michalmonday/xohw23-121/images/block_design.pdf

### DDR FIXED_IO

### axi_gpio_0

### AXI GPIO

S_AXI | GPIO
| gpio_io_o[31:0] GPIO2

gpio2_io_i[31:0]

s_axi_aclk

s_axi_aresetn

### axi_gpio_1

### AXI GPIO

S_AXI | GPIO

gpio_io_o[31:0] s_axi_aclk

s_axi_aresetn

### axi_smc

### AXI SmartConnect

S00_AXI

# M00_AXI M01_AXI M02_AXI M03_AXI M04_AXI M05_AXI M06_AXI M07_AXI

aclk aresetn

### bram_loader

S_AXI | Dout[0:0]
s_axi_aclk s_axi_aresetn | data[255:0] addr[31:0]

### bram_logic

Din[352:0] Op1[0:0] | Dout[0:0]
clka | dina[255:0]
rst_n | delayed_sig
| addra[31:0] douta[255:0]

web[0:0] addrb[31:0] dinb[255:0]

### console_io

S_AXI

clk Op2[0:0] | rd_en[0:0] wr_en wr_data[7:0] | counter[10:0] empty

rd_data[7:0]

counter1[10:0]

s_axi_aresetn

rst_n1

rst_n2 Op3[0:0] Op1[63:0]

### continuous_monitoring_system_blocks

M_AXIS

S_AXI_LITE

M00_AXI

S_AXI aresetn

aclk

axis_wr_data_count[31:0]

performance_events[38:0] en

tlast_interval[31:0] pc[63:0]

instr[31:0]

auipc_counter_probe2[6:0] auipc_event_probe2

data_pkt_auipc_counter_probe1[6:0] data_pkt_branch_counter_probe1[6:0] data_pkt_instr_probe1[32:0] data_pkt_jal_counter_probe1[6:0] data_pkt_pc_probe1[63:0] performance_counters_rst_n_probe1

branch_counter_probe3[6:0] branch_event_probe3

jal_counter_probe3[6:0]

jal_event_probe3

### gpio_0

### Slice

Din[31:0] | Dout[0:0]

### gpio_1_rst_console_input

### Slice

Din[31:0] | Dout[0:0]

### gpio_2_rst_console_output

### Slice

Din[31:0] | Dout[0:0]

### mkSoC_Top_1

### mkSoC_Top_v1_0

CLK RST_N

EN_to_raw_mem_request_get

to_raw_mem_request_get[352:0] RDY_to_raw_mem_request_get

to_raw_mem_response_put[255:0] EN_to_raw_mem_response_put

RDY_to_raw_mem_response_put

EN_get_to_console_get

get_to_console_get[7:0] RDY_get_to_console_get

put_from_console_put[7:0] EN_put_from_console_put

RDY_put_from_console_put

status[7:0]

set_verbosity_verbosity[3:0]

set_verbosity_logdelay[63:0] EN_set_verbosity

RDY_set_verbosity

set_watch_tohost_watch_tohost

set_watch_tohost_tohost_addr[63:0] EN_set_watch_tohost

RDY_set_watch_tohost mv_tohost_value[63:0] RDY_mv_tohost_value

EN_ma_ddr4_ready

RDY_ma_ddr4_ready mv_status[7:0]

cms_ifc_pc[63:0]

cms_ifc_instr[31:0]

cms_ifc_pc_valid[8:0]

cms_ifc_stage1_ostatus[1:0]

cms_ifc_stage1_control[3:0]

cms_ifc_stage2_ostatus[1:0]

cms_ifc_performance_events[38:0]

cms_ifc_perf_jal

cms_ifc_perf_branch

cms_ifc_perf_auipc

### proc_sys_reset_0

### Processor System Reset

slowest_sync_clk ext_reset_in

aux_reset_in mb_debug_sys_rst dcm_locked

mb_reset bus_struct_reset[0:0] peripheral_reset[0:0]

interconnect_aresetn[0:0] peripheral_aresetn[0:0]

### processing_system7_0

### ZYNQ7 Processing System

DDR

FIXED_IO

USBIND_0 S_AXI_HP0_FIFO_CTRL | M_AXI_GP0 S_AXI_HP0 | TTC0_WAVE0_OUT

TTC0_WAVE1_OUT

TTC0_WAVE2_OUT

M_AXI_GP0_ACLK

S_AXI_HP0_ACLK

FCLK_CLK0 FCLK_RESET0_N

### system_ila_0

### System ILA

SLOT_0_AXIS
clk probe0[255:0] probe1[0:0] probe2[31:0] probe3[63:0] probe4[0:0] probe5[31:0] probe6[255:0] probe7[0:0] probe8[7:0] probe9[0:0] probe10[0:0] probe11[10:0] probe12[10:0] probe13[0:0] probe14[0:0] probe15[0:0] probe16[7:0] probe17[6:0] probe18[0:0]

resetn
probe19[6:0] probe20[6:0] probe21[32:0] probe22[6:0] probe23[63:0] probe24[0:0] probe25[6:0] probe26[0:0] probe27[6:0] probe28[0:0]

### xlconstant_0

### Constant

dout[0:0]

## GPIO bit index=0 Controls reset line (active low)

After importing EMIO GPIOs in pynq, it isn't possible to use DMA anymore (because it seems to use these)

## GPIO bit index=1 Controls EN_cpu_reset_server_request_put (tells CPU to reset itself)

GPIO bit index=3 Select FIFO (to avoid FIFO being filled during transfer to PS which results in pynq error)

## RDY_to_raw_mem_response_put looks always HIGH

EN_cpu_reset_server_response_get acknowledges that the notification about complete core reset was received
