michalmonday/xohw23-121/images/block_design_2.png

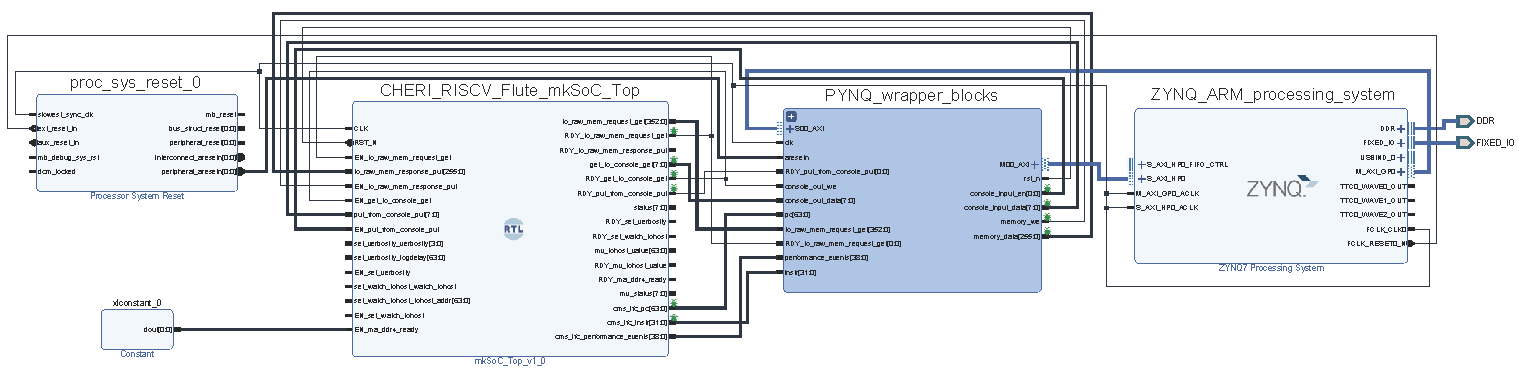
images/block_design_2.png
