michalmonday/xohw23-121/images/block_design_gpio_to_cms_ctrl_interface.png

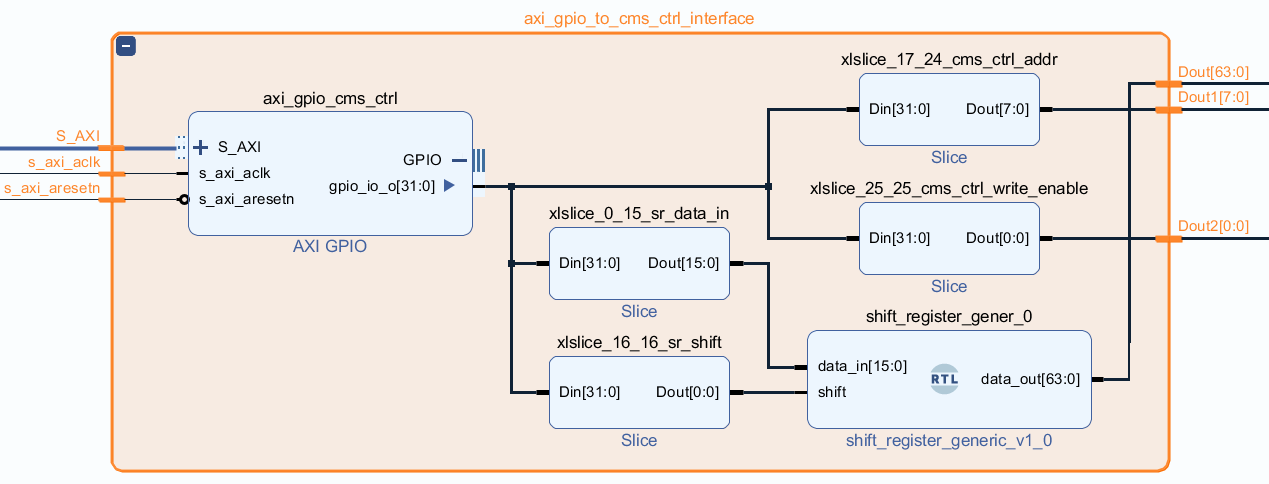
images/block_design_gpio_to_cms_ctrl_interface.png
