michalmonday/xohw23-121/images/block_design_sensors_blocks.png

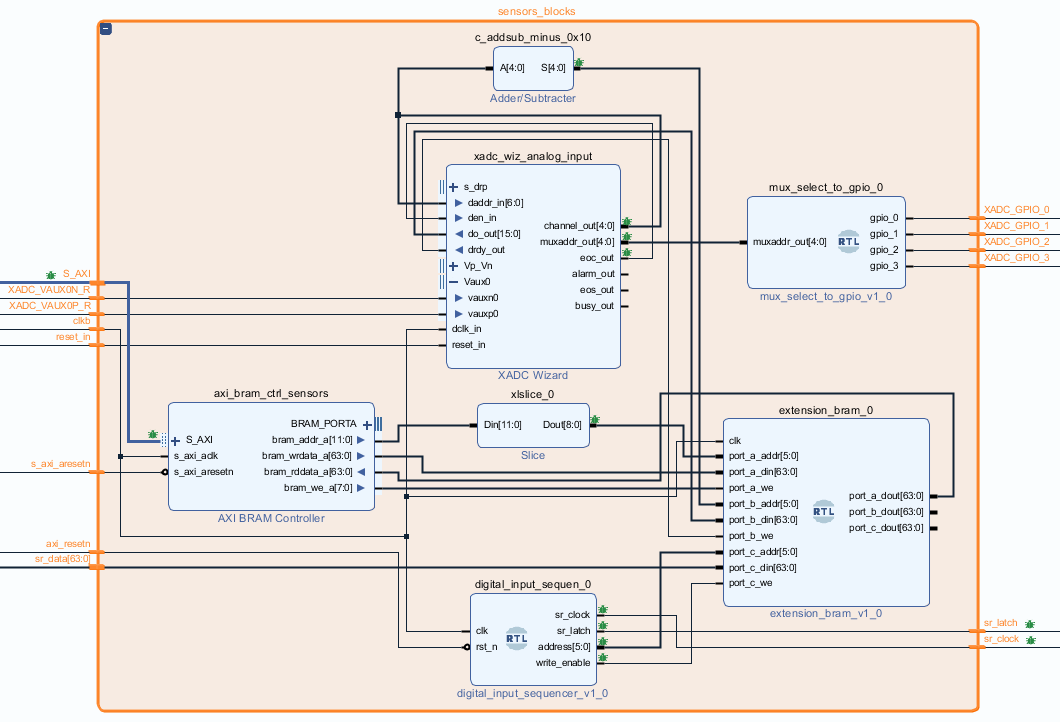
images/block_design_sensors_blocks.png
