michalmonday/xohw23-121/images/cms_configuration.png

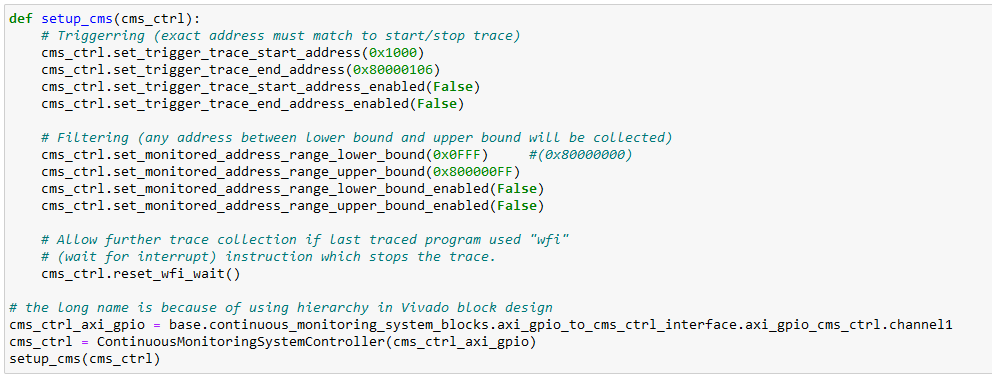
images/cms_configuration.png
