michalmonday/xohw23-121/images/cms_configuration_definitions.png

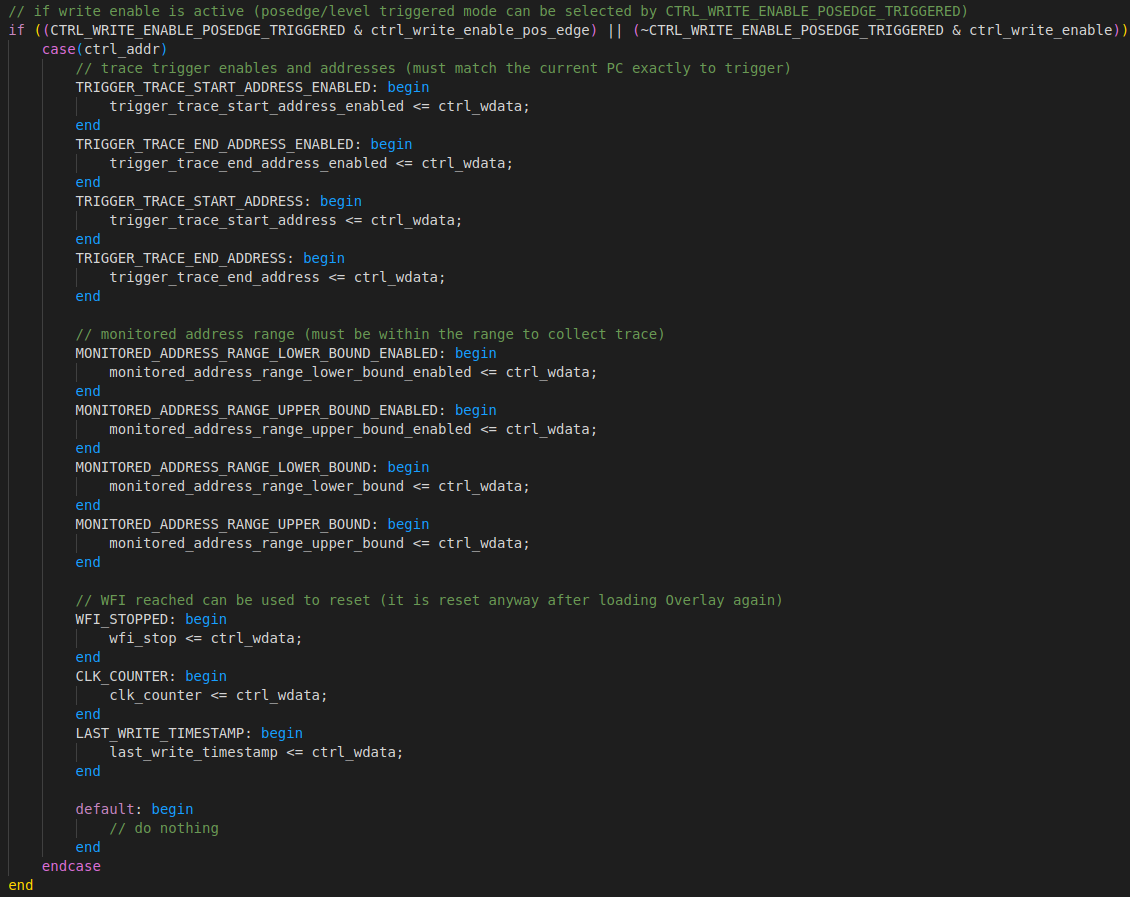
images/cms_configuration_definitions.png
