michalmonday/xohw23-121/images/cms_ifc.png

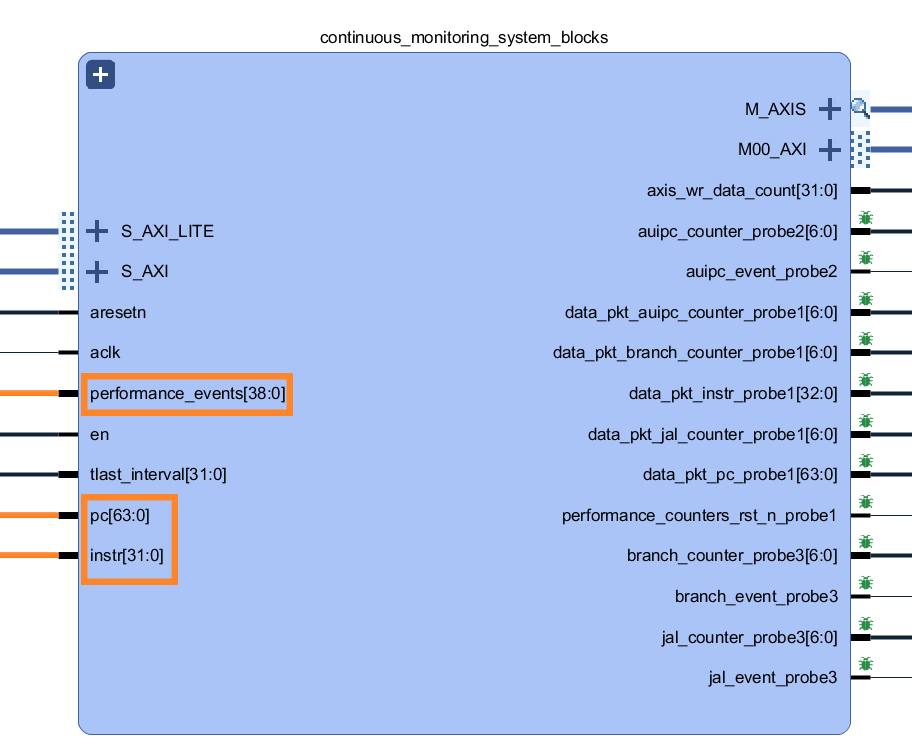
images/cms_ifc.png
