michalmonday/xohw23-121/images/datapath.png

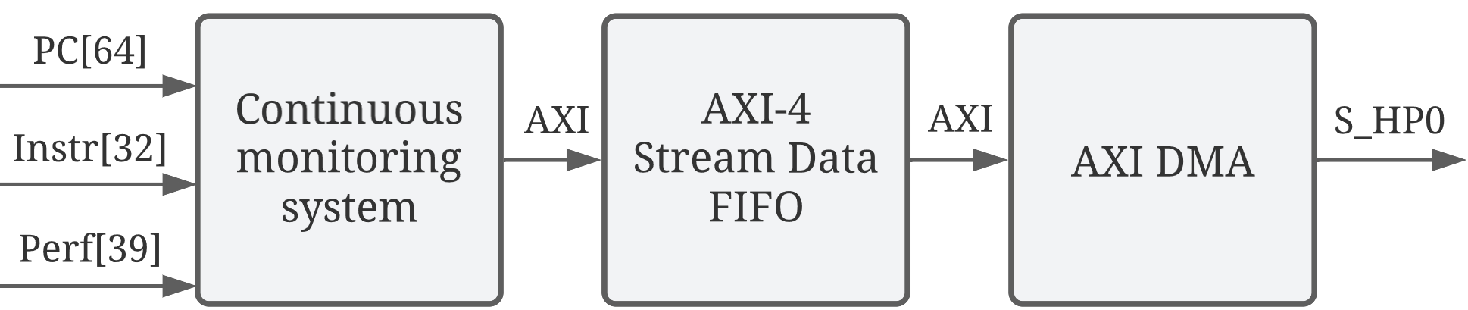
images/datapath.png
