michalmonday/xohw23-121/images/display.png

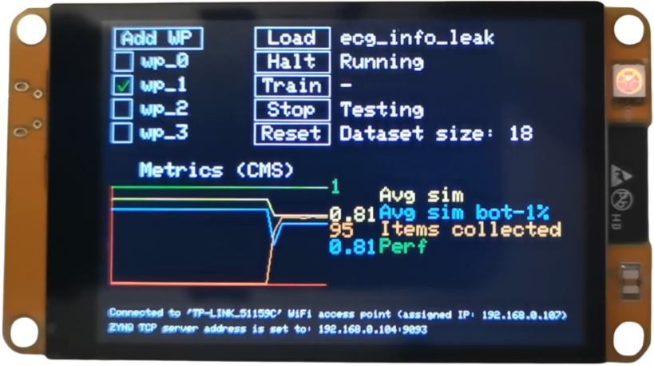
images/display.png
