michalmonday/xohw23-121/images/jupyter_notebook.png

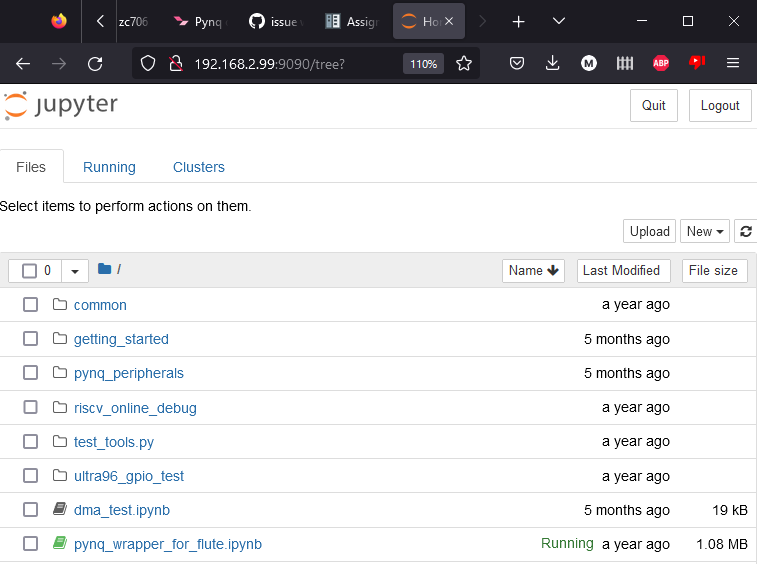
images/jupyter_notebook.png
