michalmonday/xohw23-121/images/other_peripherals_address_map.png

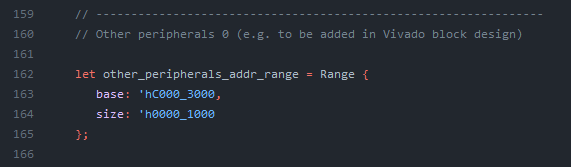
images/other_peripherals_address_map.png
