michalmonday/xohw23-121/images/overview.png

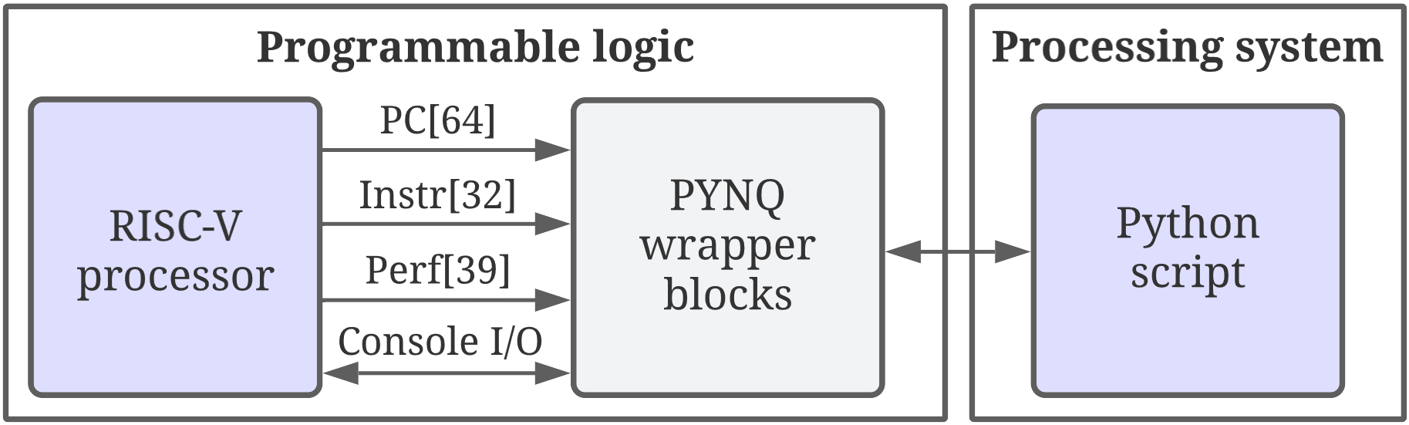
images/overview.png
