michalmonday/xohw23-121/images/overview_detailed.png

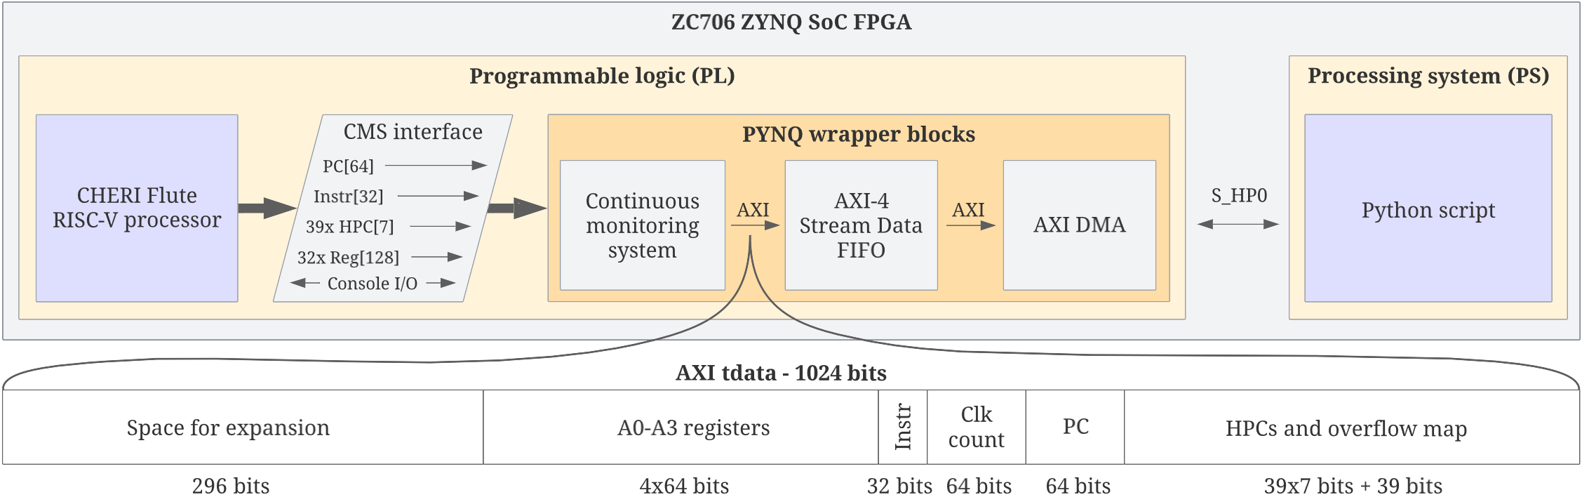
images/overview_detailed.png
