michalmonday/xohw23-121/images/overview_detailed_2.png

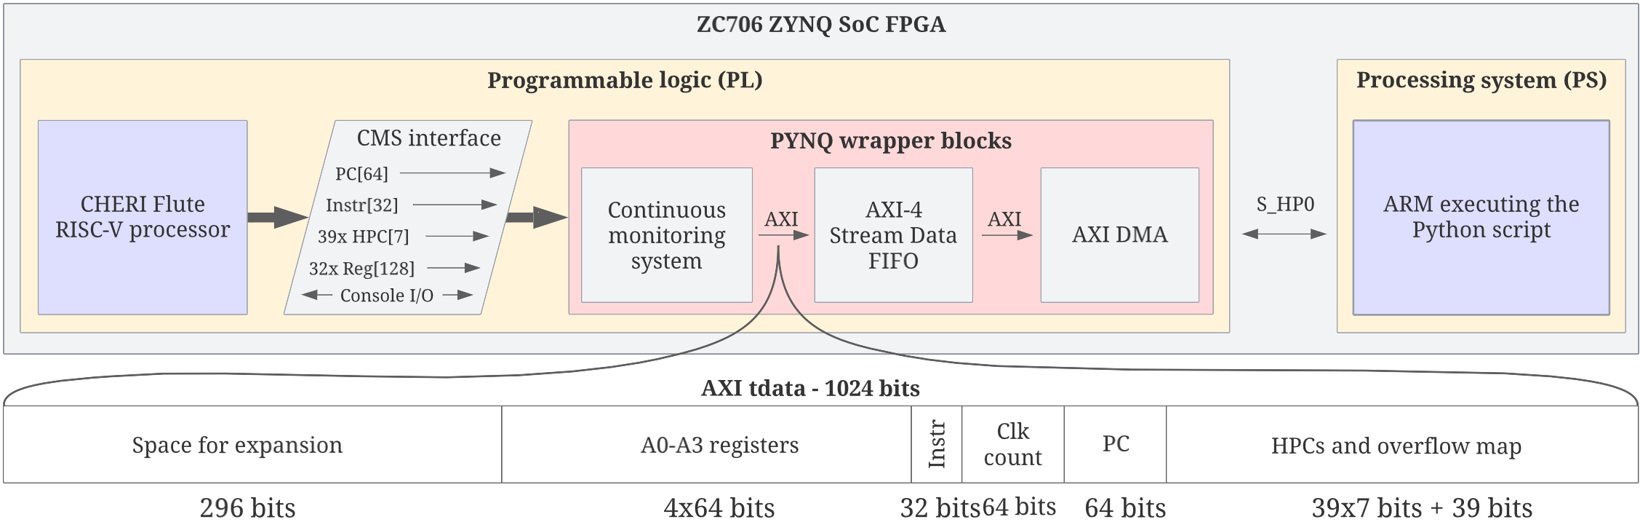
images/overview_detailed_2.png
