michalmonday/xohw23-121/images/pynq_overview.png

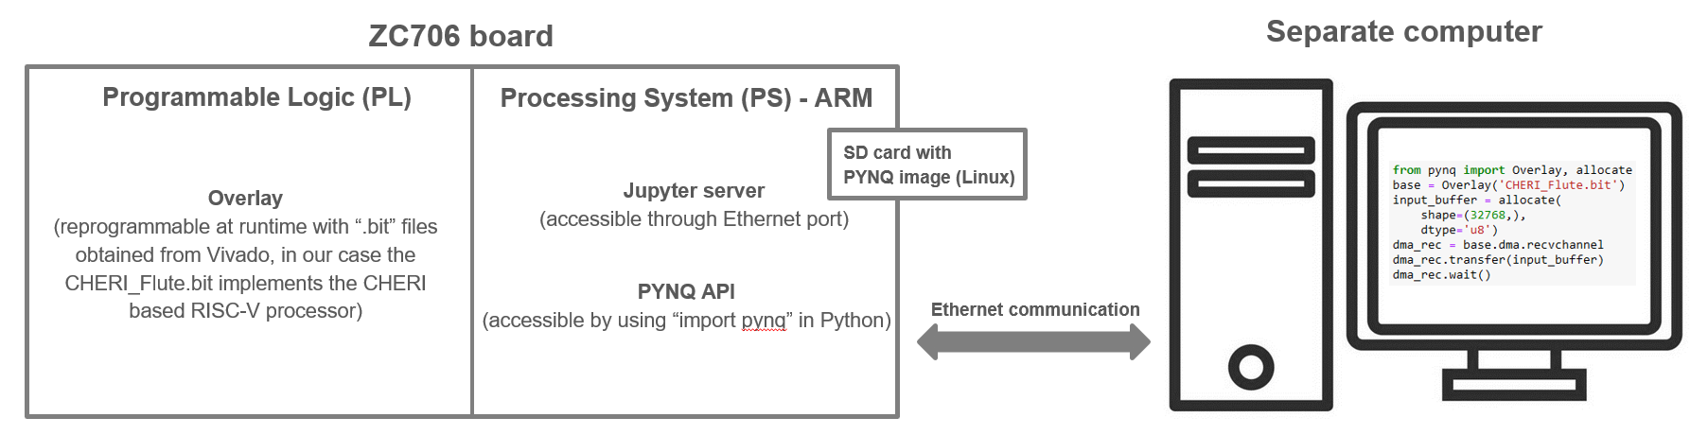
images/pynq_overview.png
