michalmonday/xohw23-121/images/soc_map_modification.png

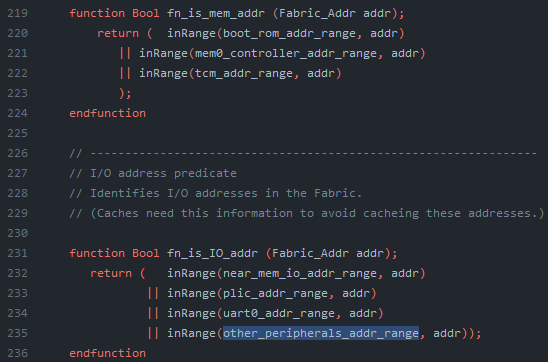
images/soc_map_modification.png
