michalmonday/xohw23-121/images/static_ip.png

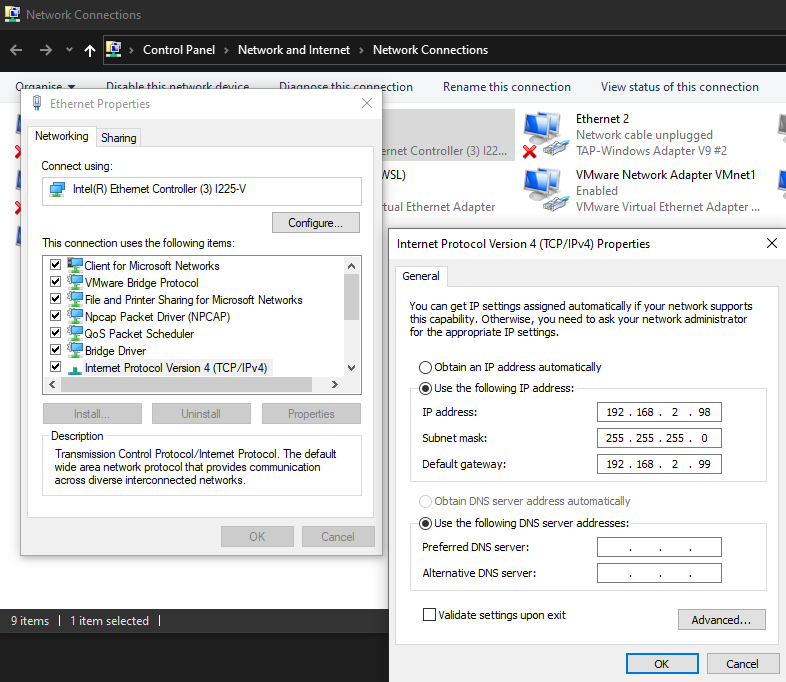
images/static_ip.png
