michalmonday/xohw23-121/images/tdata.png

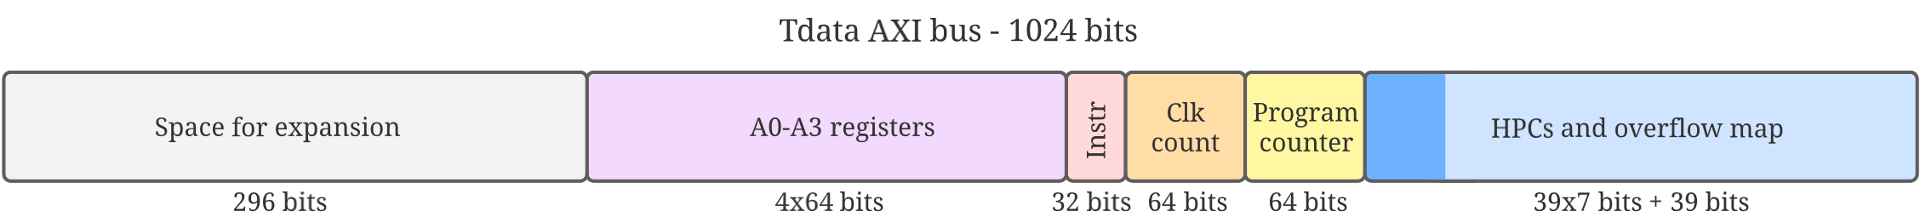
images/tdata.png
