michalmonday/xohw23-121/images/throughput.png

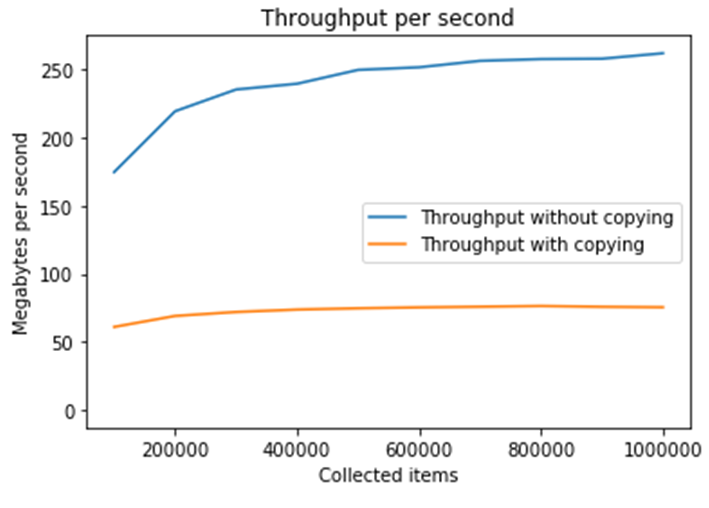
images/throughput.png
