michalmonday/xohw23-121/images/throughput_bigger_font.png

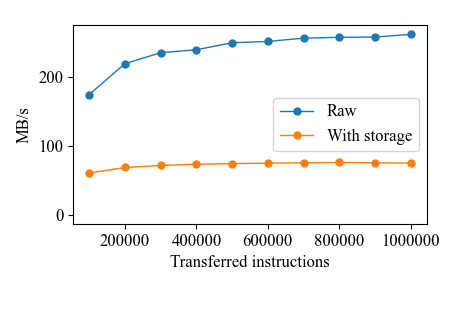
images/throughput_bigger_font.png
