michalmonday/xohw23-121/images/vulnerability.png

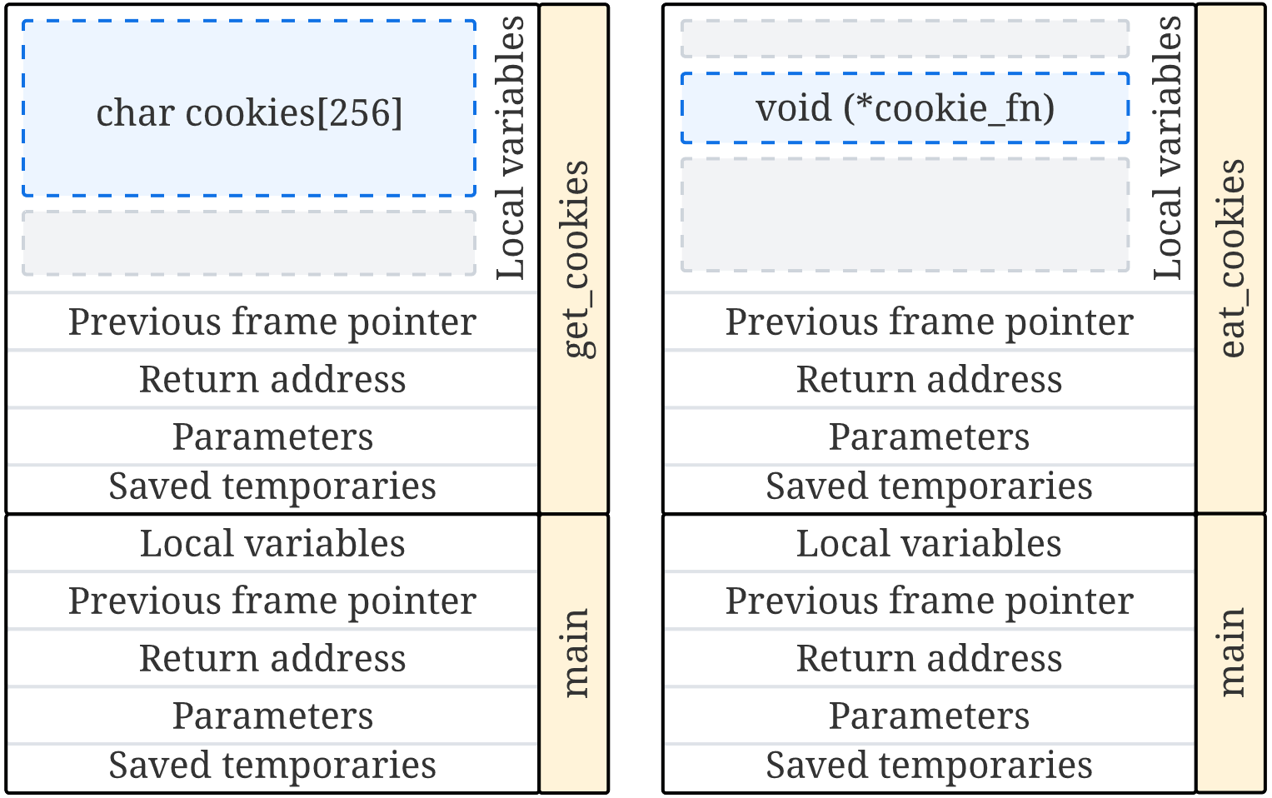
images/vulnerability.png
