michalmonday/xohw23-121/images/vulnerability_shorter.png

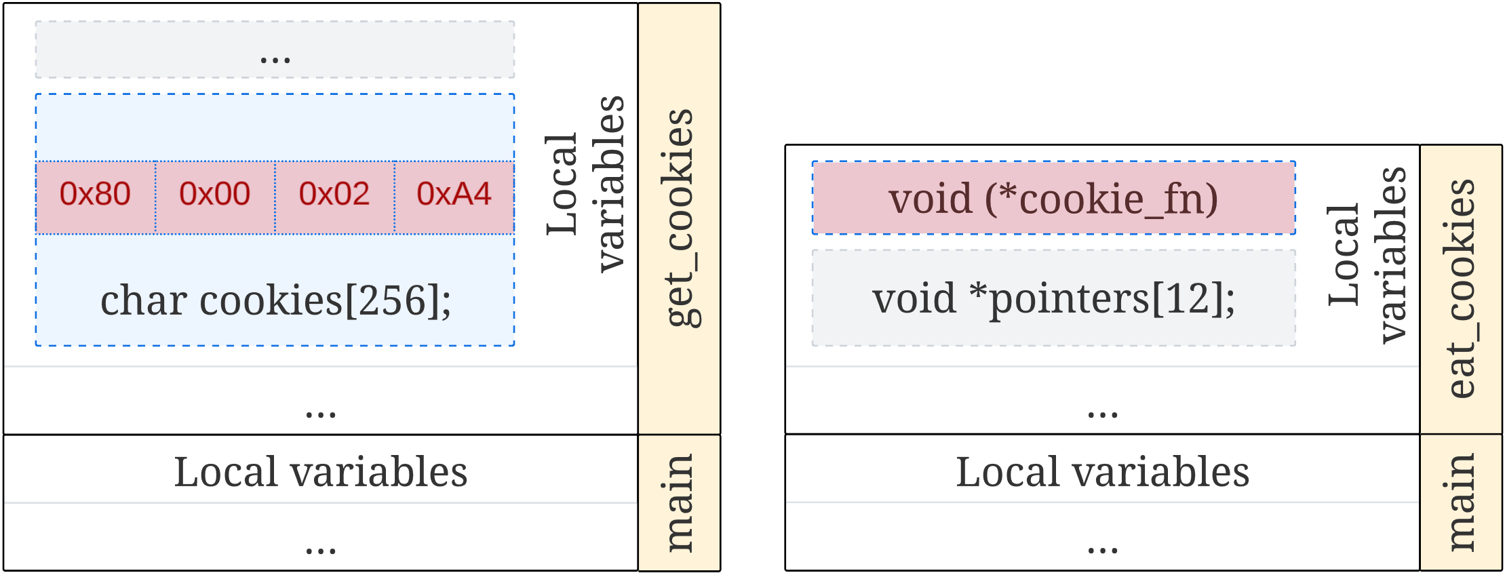
images/vulnerability_shorter.png
