michalmonday/xohw23-121/images/workaround_bram_controller_address.png

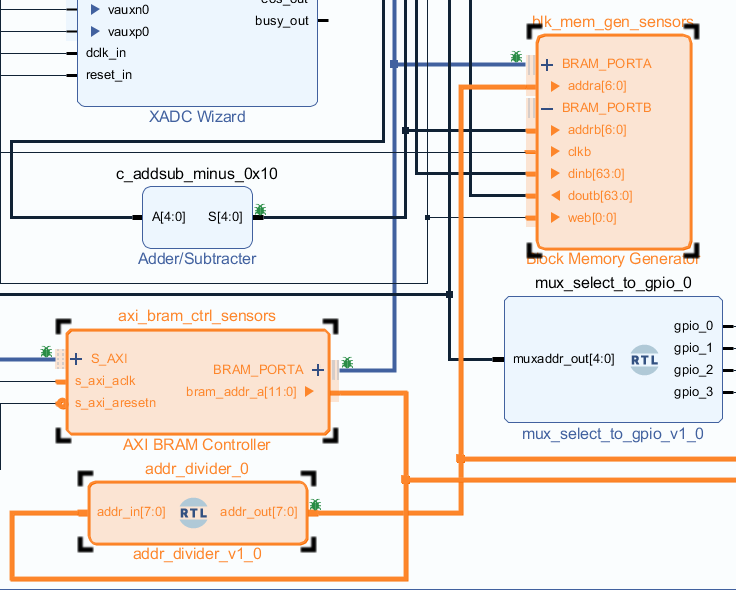
images/workaround_bram_controller_address.png
