michalmonday/xohw23-121/images/xadc_header_j63.png

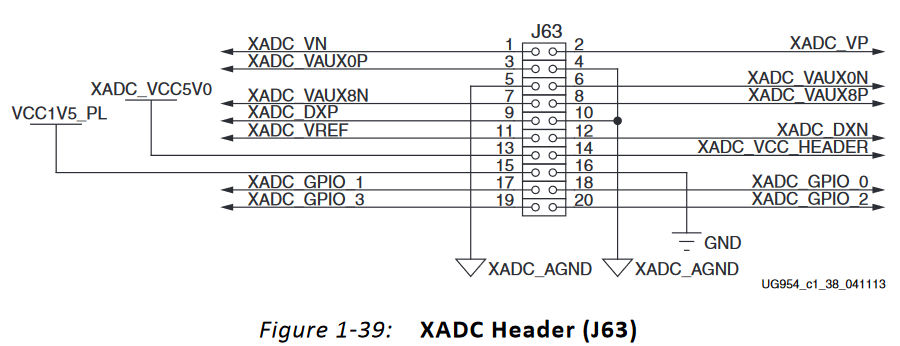
images/xadc_header_j63.png
