michalmonday/xohw23-121/images/zoomed_in_plot.png

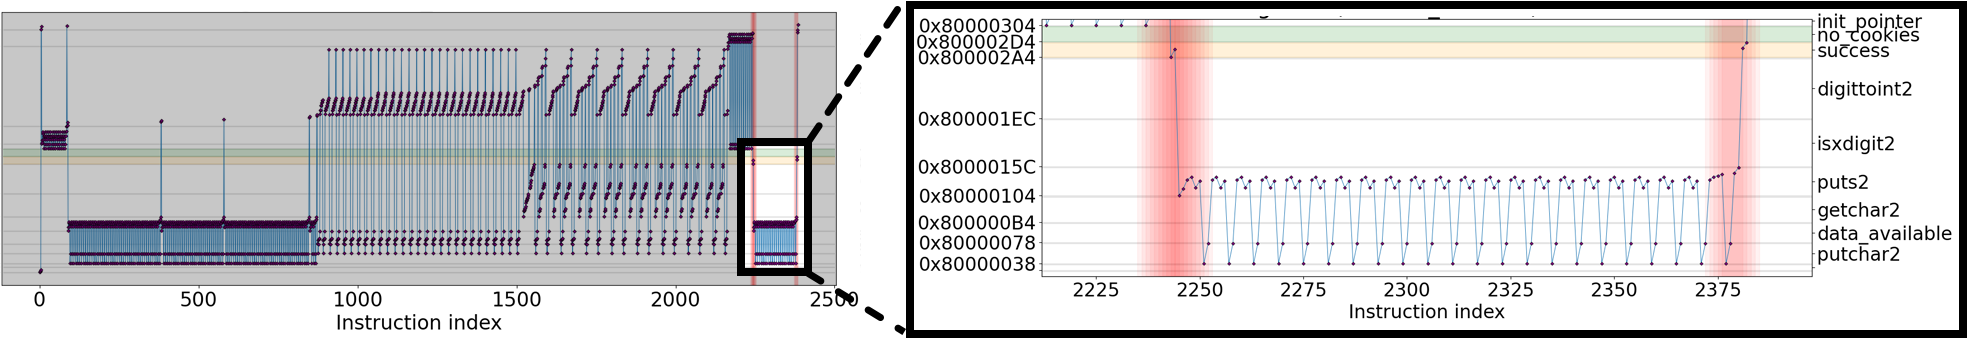
images/zoomed_in_plot.png
