michalmonday/xohw23-121/images/performance_events_variations.png

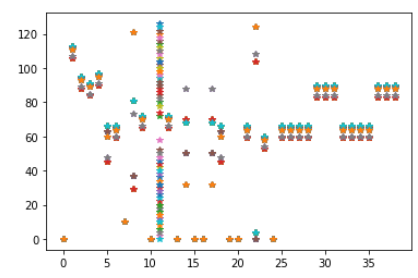
images/performance_events_variations.png
