michalmonday/xohw23-121/images/performance_penalty.png

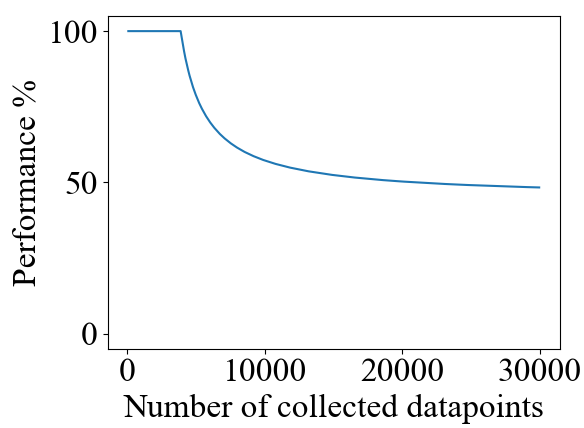
images/performance_penalty.png
