michalmonday/xohw23-121/images/performance_penalty_2.png

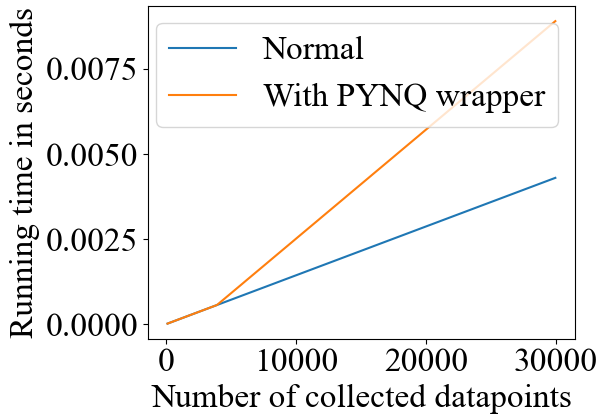
images/performance_penalty_2.png
