michalmonday/xohw23-121/images/results_bigger_font2.pdf

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

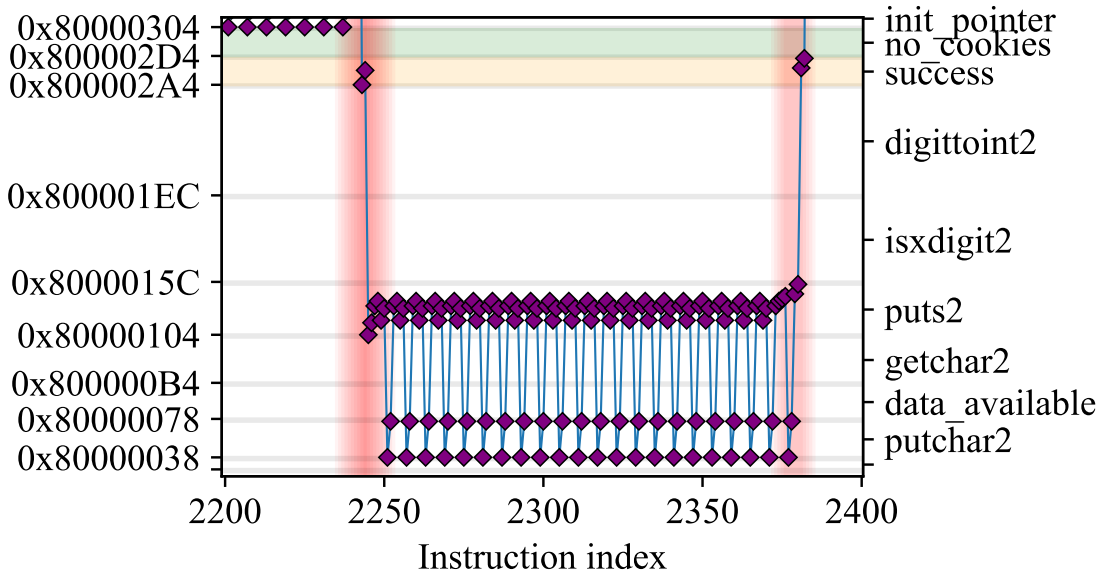
[picture p79: page 1]
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
