michalmonday/xohw23-121/display_board/src/touch_print/touch_print.cpp

#include "TAMC_GT911.h"
 // 63
#define TOUCH_SDA  19
#define TOUCH_SCL  20
#define TOUCH_INT -1
#define TOUCH_RST 38
#define TOUCH_WIDTH  800
#define TOUCH_HEIGHT 480

// #define TOUCH_GT911_SCL 20
// #define TOUCH_GT911_SDA 19
// #define TOUCH_GT911_INT -1
// #define TOUCH_GT911_RST 38

TAMC_GT911 *tp;

void setup() {
  Serial.begin(115200);
  Serial.println("TAMC_GT911 Example: Ready");
  tp = new TAMC_GT911(TOUCH_SDA, TOUCH_SCL, TOUCH_INT, TOUCH_RST, TOUCH_WIDTH, TOUCH_HEIGHT);
  tp->begin();
  // tp->setRotation(ROTATION_LEFT);
  // tp->setRotation(ROTATION_NORMAL);
  tp->setRotation(ROTATION_INVERTED);
}

void loop() {
  tp->read();
  if (tp->isTouched){
    for (int i=0; i<tp->touches; i++){
      Serial.print("Touch ");Serial.print(i+1);Serial.print(": ");;
      Serial.print("  x: ");Serial.print(tp->points[i].x);
      Serial.print("  y: ");Serial.print(tp->points[i].y);
      Serial.print("  size: ");Serial.println(tp->points[i].size);
      Serial.println(' ');
    }
  }
}
