michalmonday/xohw23-121/vivado_files/src_verilog/custom_hdl/console_io_dma.v

/*
This module is responsible for intermediate storage and interfacing between RISC-V console input/output and the Python script (using AXI DMA).
*/
`timescale 1ns/10ps

module console_io_dma #(
    DATA_DEPTH = 1000
) (
    input clk,
    input rst_n,

    // in DMA version these 2 signals must be replaced

    // this was providing read enable for output, write enable for input, and input data
    // input [31:0] AXI_GPIO_input, 

    // this was providing output data, and output empty status
    // output reg [31:0] AXI_GPIO_output = 0,

    // input output_read_en,
    input output_tready,
    output reg [7:0]output_data_reg,
    output reg output_tvalid_delayed,

    input [7:0]input_data,
    input input_write_en,
    output wire input_not_full,

    // input fifo signals
    input rst_n_input_fifo,
    input cpu_reset_completed,
    input RDY_put_from_console_put,
    output wire [7:0] put_from_console_put,
    output reg EN_put_from_console_put = 0,
    output wire [10:0] input_fifo_counter,

    // output fifo signals
    input rst_n_output_fifo,
    input [7:0] get_to_console_get,
    input RDY_get_to_console_get,
    output wire [10:0] output_fifo_counter,
    input wire receive_transfer_request,
    output reg output_tlast_reg
);
    wire input_fifo_wr_en; 
    wire input_fifo_empty;
    reg input_fifo_rd_en = 0;// wire  = (rst_n & cpu_reset_completed & RDY_put_from_console_put & ~input_fifo_empty);

    wire output_fifo_wr_en = RDY_get_to_console_get || receive_transfer_request;
    wire output_fifo_empty;
    wire [7:0] output_data;
    wire [7:0] output_fifo_wr_data = receive_transfer_request ? 'hFF : get_to_console_get;

    assign input_not_full = input_fifo_counter < DATA_DEPTH-1;
    assign last_output_char_available = output_fifo_counter == 1;

    // detects that RDY_put_from_console_put has gone from 1 to 0 and the char can't be sent
    // (char is outputted by fifo after 1 clock cycle of enabling read, and at that point the RDY_put_from_console_put may be already 0)
    reg RDY_put_from_console_put_was_off = 0;

    wire output_read_en = output_tready & (~output_fifo_empty || RDY_get_to_console_get);

    wire output_tlast;
    reg output_tvalid;

    // output fifo isn't expected to be read at such high speed (it's read by AXI GPIO)
    // so such mechanism is not needed (at least for now)

    // edge_detector input_fifo_wr_en_edge_detector(
    //     .clk(clk),
    //     .sig(AXI_GPIO_input[8]),
    //     .pos_edge(input_fifo_wr_en)
    // );

    sync_fifo #(
        .DATA_DEPTH(DATA_DEPTH),
        .DATA_WIDTH(8)
    ) input_fifo (
        .clk(clk),
        .rst_n(rst_n_input_fifo),
        .rd_en(input_fifo_rd_en),
        .wr_en(input_write_en & input_not_full),
        .wr_data(input_data),
        .rd_data(put_from_console_put),
        .full(),
        .empty(input_fifo_empty),
        .half(),
        .counter(input_fifo_counter)
    );

    // while keeping it empty
    // always @(posedge clk) begin
    //     AXI_GPIO_output <= {output_fifo_empty, output_data};
    // end
    always @(posedge clk) begin
        // if fifo is empty but both: read enable and write enable are HIGH,
        // then the char is outputted by fifo while keeping it empty
        output_tvalid_delayed <= output_tvalid;
        output_tvalid <= output_read_en;

        output_data_reg <= output_data;
        output_tlast_reg <= output_tlast; 
    end

    always @(posedge clk) begin
        if(!rst_n) begin
            EN_put_from_console_put <= 0;
        end
        else begin
            if (rst_n & cpu_reset_completed & RDY_put_from_console_put & ~input_fifo_empty & ~input_fifo_rd_en & ~EN_put_from_console_put) begin
                input_fifo_rd_en <= 1;
            end
            else begin
                input_fifo_rd_en <= 0;
            end
            EN_put_from_console_put <= input_fifo_rd_en;

            // if (~RDY_put_from_console_put) begin
            //     if (input_fifo_rd_en) begin
            //         RDY_put_from_console_put_was_off <= 1;
            //     end
            //     EN_put_from_console_put <= 0;
            // end
            // else if (RDY_put_from_console_put_was_off) begin
            //     // if the last char couldn't be sent and the RDY_put_from_console_put has gone from 0 to 1, then send the char
            //     RDY_put_from_console_put_was_off <= 0;
            //     EN_put_from_console_put <= 1;
            // end
            // else begin
            //     EN_put_from_console_put <= input_fifo_rd_en;
            // end
        end
    end


    // edge_detector output_fifo_rd_en_edge_detector(
    //     .clk(clk),
    //     .sig(AXI_GPIO_input[9]),
    //     .pos_edge(output_fifo_rd_en)
    // );
    sync_fifo  #(
        .DATA_DEPTH(DATA_DEPTH),
        .DATA_WIDTH(8 + 1) // +1 for tlast
    ) output_fifo (
        .clk(clk),
        .rst_n(rst_n_output_fifo),
        .rd_en(output_read_en),
        .wr_en(output_fifo_wr_en),
        .wr_data({receive_transfer_request, output_fifo_wr_data}), // receive_transfer_request is used as tlast
        .rd_data({output_tlast, output_data}), 
        .full(),
        .empty(output_fifo_empty),
        .half(),
        .counter(output_fifo_counter)
    );

endmodule
