michalmonday/xohw23-121/vivado_files/src_verilog/src_bsc_lib_RTL/RegFile.v

// Copyright (c) 2000-2009 Bluespec, Inc.

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
// $Revision: 24080 $
// $Date: 2011-05-18 15:32:52 -0400 (Wed, 18 May 2011) $

`ifdef  BSV_WARN_REGFILE_ADDR_RANGE
`else
`define BSV_WARN_REGFILE_ADDR_RANGE 0 
`endif


`ifdef BSV_ASSIGNMENT_DELAY
`else
`define BSV_ASSIGNMENT_DELAY
`endif


// Multi-ported Register File
module RegFile(CLK,
               ADDR_IN, D_IN, WE,
               ADDR_1, D_OUT_1,
               ADDR_2, D_OUT_2,
               ADDR_3, D_OUT_3,
               ADDR_4, D_OUT_4,
               ADDR_5, D_OUT_5,
               ADDR_6, D_OUT_6,
               ADDR_7, D_OUT_7,
               ADDR_8, D_OUT_8,
               ADDR_9, D_OUT_9
               );
   parameter                   addr_width = 1;
   parameter                   data_width = 1;
   parameter                   lo = 0;
   parameter                   hi = 1;

   input                       CLK;
   input [addr_width - 1 : 0]  ADDR_IN;
   input [data_width - 1 : 0]  D_IN;
   input                       WE;

   input [addr_width - 1 : 0]  ADDR_1;
   output [data_width - 1 : 0] D_OUT_1;

   input [addr_width - 1 : 0]  ADDR_2;
   output [data_width - 1 : 0] D_OUT_2;

   input [addr_width - 1 : 0]  ADDR_3;
   output [data_width - 1 : 0] D_OUT_3;

   input [addr_width - 1 : 0]  ADDR_4;
   output [data_width - 1 : 0] D_OUT_4;

   input [addr_width - 1 : 0]  ADDR_5;
   output [data_width - 1 : 0] D_OUT_5;

   input [addr_width - 1 : 0]  ADDR_6;
   output [data_width - 1 : 0] D_OUT_6;

   input [addr_width - 1 : 0]  ADDR_7;
   output [data_width - 1 : 0] D_OUT_7;

   input [addr_width - 1 : 0]  ADDR_8;
   output [data_width - 1 : 0] D_OUT_8;

   input [addr_width - 1 : 0]  ADDR_9;
   output [data_width - 1 : 0] D_OUT_9;

   reg [data_width - 1 : 0]    arr[lo:hi];


`ifdef BSV_NO_INITIAL_BLOCKS
`else // not BSV_NO_INITIAL_BLOCKS
   // synopsys translate_off
   initial
     begin : init_block
        integer                     i; 		// temporary for generate reset value
        for (i = lo; i <= hi; i = i + 1) begin
           arr[i] = {((data_width + 1)/2){2'b10}} ;
        end
     end // initial begin
   // synopsys translate_on
`endif // BSV_NO_INITIAL_BLOCKS


   always@(posedge CLK)
     begin
        if (WE)
          arr[ADDR_IN] <= `BSV_ASSIGNMENT_DELAY D_IN;
     end // always@ (posedge CLK)

   assign D_OUT_1 = arr[ADDR_1];
   assign D_OUT_2 = arr[ADDR_2];
   assign D_OUT_3 = arr[ADDR_3];
   assign D_OUT_4 = arr[ADDR_4];
   assign D_OUT_5 = arr[ADDR_5];
   assign D_OUT_6 = arr[ADDR_6];
   assign D_OUT_7 = arr[ADDR_7];
   assign D_OUT_8 = arr[ADDR_8];
   assign D_OUT_9 = arr[ADDR_9];


   // synopsys translate_off
   always@(posedge CLK)
     begin : runtime_check
        reg enable_check;
        enable_check = `BSV_WARN_REGFILE_ADDR_RANGE ;
        if ( enable_check )
           begin
              if (( ADDR_1 < lo ) || (ADDR_1 > hi) )
                $display( "Warning: RegFile: %m -- Address port 1 is out of bounds: %h", ADDR_1 ) ;
              if (( ADDR_2 < lo ) || (ADDR_2 > hi) )
                $display( "Warning: RegFile: %m -- Address port 2 is out of bounds: %h", ADDR_2 ) ;
              if (( ADDR_3 < lo ) || (ADDR_3 > hi) )
                $display( "Warning: RegFile: %m -- Address port 3 is out of bounds: %h", ADDR_3 ) ;
              if (( ADDR_4 < lo ) || (ADDR_4 > hi) )
                $display( "Warning: RegFile: %m -- Address port 4 is out of bounds: %h", ADDR_4 ) ;
              if (( ADDR_5 < lo ) || (ADDR_5 > hi) )
                $display( "Warning: RegFile: %m -- Address port 5 is out of bounds: %h", ADDR_5 ) ;
              if (( ADDR_6 < lo ) || (ADDR_6 > hi) )
                $display( "Warning: RegFile: %m -- Address port 6 is out of bounds: %h", ADDR_6 ) ;
              if (( ADDR_7 < lo ) || (ADDR_7 > hi) )
                $display( "Warning: RegFile: %m -- Address port 7 is out of bounds: %h", ADDR_7 ) ;
              if (( ADDR_8 < lo ) || (ADDR_8 > hi) )
                $display( "Warning: RegFile: %m -- Address port 8 is out of bounds: %h", ADDR_8 ) ;
              if (( ADDR_9 < lo ) || (ADDR_9 > hi) )
                $display( "Warning: RegFile: %m -- Address port 9 is out of bounds: %h", ADDR_9 ) ;
              if ( WE && ( ADDR_IN < lo ) || (ADDR_IN > hi) )
                $display( "Warning: RegFile: %m -- Write Address port is out of bounds: %h", ADDR_IN ) ;
           end
     end
   // synopsys translate_on

endmodule
