michalmonday/xohw23-121/display_board/src/CMS/gui_state_main.h

#ifndef GUI_STATE_MAIN_H
#define GUI_STATE_MAIN_H

#include <Arduino.h>


#include <gui_state.h>
#include <gui_label.h>
#include <gui_graph.h>
#include <gui_button.h>
#include "watchpoint.h"

#include "graphics.h"

class GUI_CMS;
class GUI_Button;

class GUI_State_Main : public GUI_State {
public:
    GUI_State_Main(Graphics *gfx, GUI_CMS *gui, Touch *touch);
    virtual void update() override;
    virtual void reset() override;
    virtual void draw() override;
    virtual void on_state_enter() override;
    virtual void on_state_exit() override;
    void set_ap_conn_status(String text);
    void set_tcp_conn_status(String text);
    void set_loaded_program(String text);
    void set_run_status(String text);
    void set_training_status(String text);
    void set_testing_status(String text);
    void set_dataset_size(int size);
    // GUI_Graph *get_ecg_graph() { return ecg_graph; }
    GUI_Graph *get_pynq_graph() { return pynq_graph; }
    GUI_Label *get_label_ap_conn_status() { return label_ap_conn_status; }
    GUI_Label *get_label_tcp_conn_status() { return label_tcp_conn_status; }
    int get_dataset_size() { return dataset_size; }

    Watchpoint* add_atf_watchpoint();
    void clear_atf_watchpoints();
private:
    int dataset_size;
    // GUI_Graph *ecg_graph;
    GUI_Graph *pynq_graph;
    GUI_Label *label_ap_conn_status;
    GUI_Label *label_tcp_conn_status;

    GUI_Label *label_loaded_program;
    GUI_Label *label_run_status;
    GUI_Label *label_training_status;
    GUI_Label *label_testing_status;
    GUI_Label *label_dataset_size;

    GUI_Button *btn_load_program;
    GUI_Button *btn_run_status;
    GUI_Button *btn_train;
    GUI_Button *btn_test;
    GUI_Button *btn_reset_dataset;
    // GUI_Button *btn_server_ip;

    // watchpoints section
    // GUI_Label *label_watchpoints;
    GUI_Button *btn_add_new_watchpoint;

    std::vector<Watchpoint*> watchpoints;

    const int button_width = RESOLUTION_X * 0.12;
    // const int button_height = RESOLUTION_Y * 0.15;
    const int button_x = RESOLUTION_X * 0.32; // RESOLUTION_X*0.48;
    const int button_y_start = RESOLUTION_Y*0.02;
    const int button_font_size = 2;
    int button_height; //fontHeight * something // = RESOLUTION_Y * 0.07;
    int button_offset;  //button_height * something // button_height*1.1; // button_height * 1.3;

    const int pynq_graph_x = RESOLUTION_X*0.02;
    // const int pynq_graph_w = RESOLUTION_X*0.45; // good for 3.5" screen
    const int pynq_graph_w = RESOLUTION_X*0.6;    // good for 7" screen
    // const int pynq_graph_y = RESOLUTION_Y*0.62;
    // const int pynq_graph_h = RESOLUTION_Y*0.2; 
    const int pynq_graph_y = RESOLUTION_Y*0.52;
    const int pynq_graph_h = RESOLUTION_Y*0.33; 

};

#endif
