michalmonday/xohw23-121/display_board/src/CMS/gui_cms_states.h

#ifndef GUI_CMS_STATES_H
#define GUI_CMS_STATES_H

#define GUI_STATE_MAIN 0
#define GUI_STATE_NOTIFICATION 1
#define GUI_STATE_SELECT_OPTION 2
#define GUI_STATE_EDIT_WATCHPOINT 3
#define GUI_STATE_SELECT_NUMBER 4
#define GUI_STATE_EXPLORE_OBJDUMP 5
#define GUI_STATE_SELECT_IP 6

#endif
