michalmonday/xohw23-121/ESP32-3248S035C_display_board/src/gui_state.cpp

#include "gui_state.h"  
// #include "gui.h"

// -------------------------------
// ---------- GUI_State ----------

GUI_State::GUI_State(TFT_eSPI *tft, GUI *gui, Touch *touch) : tft(tft), gui(gui), touch(touch) {
}

void GUI_State::update() {
    touch->update();
    bool was_pressed = touch->was_pressed();
    bool was_released = touch->was_released();
    
    if (!was_pressed && !was_released)
        return;
    
    int touch_x = touch->get_x();
    int touch_y = touch->get_y();

    for (GUI_Element *element : elements) {
        if (!element->contains_point(touch_x, touch_y))
            continue;

        if (was_pressed) 
            element->on_press();
        if (was_released) 
            element->on_release();
        break;
    }

    if (was_pressed) 
        touch->reset_last_press();
    if (was_released) 
        touch->reset_last_release();
}

void GUI_State::draw() {
    for (GUI_Element *element : elements) {
        if (element->needs_redraw)
            element->draw();
    }
}

void GUI_State::reset() {
    // elements.clear();
    schedule_redraw();
}

void GUI_State::add_element(GUI_Element* element) {
    elements.push_back(element);
    element->needs_redraw = true;
}

void GUI_State::on_state_enter() {
    Serial.println("State entered");
    for (GUI_Element *element : elements) {
        Serial.println("Redrawing element");
        element->needs_redraw = true;
    }
}

void GUI_State::on_state_exit() {
}

void GUI_State::destroy_and_clear_elements() {
    for (GUI_Element *element : elements) {
        delete element;
    }
    elements.clear();
}

void GUI_State::schedule_redraw() {
    for (GUI_Element *element : elements) {
        element->needs_redraw = true;
    }
}
