michalmonday/xohw23-121/ESP32-3248S035C_display_board/src/gui_button.cpp

#include "gui_button.h"

// -------------------------------
// ---------- GUI_Button ----------
GUI_Button::GUI_Button(TFT_eSPI *tft, String text, int x, int y, int w, int h, unsigned int font_size, unsigned int text_colour, unsigned int background_colour, std::function<void()> on_press_callback, std::function<void()> on_release_callback) :
    GUI_Element(tft, x, y, w, h, background_colour, on_press_callback, on_release_callback), text(text), font_size(font_size), text_colour(text_colour), original_background_colour(background_colour)
{
}

void GUI_Button::draw() {
    GUI_Element::draw();

    // border
    tft->drawRect(x, y, w, h, TFT_WHITE);  

    tft->setTextDatum(MC_DATUM);
    // TL_DATUM = 0 = Top left
    // TC_DATUM = 1 = Top centre
    // TR_DATUM = 2 = Top right
    // ML_DATUM = 3 = Middle left
    // MC_DATUM = 4 = Middle centre
    // MR_DATUM = 5 = Middle right
    // BL_DATUM = 6 = Bottom left
    // BC_DATUM = 7 = Bottom centre
    // BR_DATUM = 8 = Bottom right
    // L_BASELINE =  9 = Left character baseline (Line the 'A' character would sit on)
    // C_BASELINE = 10 = Centre character baseline
    // R_BASELINE = 11 = Right character baseline
    // tft->drawCentreString(text, x + w / 2, y + h / 2 , 2);
    tft->setTextColor(text_colour);
    tft->setTextSize(font_size);
    tft->drawString(text, x + w / 2, y + h / 2);
// - tft->fontHeight(2)/
}

void GUI_Button::undraw() {
    // paint over the label with the background colour
    tft->setTextDatum(MC_DATUM);
    tft->setTextColor(background_colour);
    tft->setTextSize(font_size);
    tft->drawString(text, x + w / 2, y + h / 2);
}

void GUI_Button::set_text(String text) {
    undraw();
    this->text = text;
    needs_redraw = true;
}

void GUI_Button::on_release() {
    GUI_Element::on_release();
    background_colour = original_background_colour;
    // Serial.println("Button '" + text + "' touched");
    needs_redraw = true;
}

void GUI_Button::on_press() {
    GUI_Element::on_press();
    background_colour = WHITE;
    needs_redraw = true;
}
