michalmonday/xohw23-121/ESP32-3248S035C_display_board/src/gui_button.h

#ifndef GUI_BUTTON_ESP32_H
#define GUI_BUTTON_ESP32_H

#include <TFT_eSPI.h>
#include "gui_element.h"

#include <functional>

class GUI_Button : public GUI_Element {
public:
    GUI_Button(TFT_eSPI *tft, String text, int x, int y, int w, int h, unsigned int font_size, unsigned int text_colour, unsigned int background_colour = BLACK, 
        std::function<void()> on_press_callback = [](){},
        std::function<void()> on_release = [](){}
        );
    void draw();
    void set_text(String text); 
    virtual void on_release() override;
    virtual void on_press() override;
    String get_text() { return text; }
    void undraw();
private:
    String text;
    unsigned int text_colour;
    unsigned int original_background_colour;
    unsigned int font_size;
};

#endif
