michalmonday/xohw23-121/(commit log)

2023-01-09 Smaller AXI data width, less perf counters, overflow map
    [performance_event_names_non_zero.csv]
2023-01-10 Vivado files + updated events + updated notebook
    [performance_event_names_non_zero.csv, performance_event_names_selected.csv]
2023-01-11 SW11 switch note
2023-01-12 output files + run_and_collect + decoder
    [normal_0.csv, normal_1.csv, normal_2.csv, normal_3.csv, normal_4.csv, normal_5.csv, normal_6.csv, normal_7.csv]
2023-02-24 Updated notebook (with sensors)
2023-02-25 sensors extension documentation
2023-02-27 DMA based UART (needs little refinement but works, GPIO based was slow)
2023-02-28 DMA based console IO + cleanup + updated bit/hwh/tcl
2023-02-28 Updated setup_instructions (recompiling bsc + sensors board note)
2023-03-02 note about ecg sensor
2023-03-06 Capacitive touch (TAMC_GT911 lib with a workaround)
    [ESP32-3248S035C_display_board.ino, graph.cpp]
2023-03-08 GUI development (labels, buttons, touch press/release actions)
2023-03-11 Advanced trace filter (internal storage is filled in 10s instead of 5ms)
2023-03-15 Direct rule matching (seed_masks in advanced trace filter)
2023-03-16 controller/display status updates + restore status after reset
    [ESP32-3248S035C_display_board.ino, gui_state_main.cpp]
2023-03-16 anomaly detection model thread safety + resetting it
    [anomaly_detection.py]
2023-03-20 tcp server client removal when send fails
    [anomaly_detection.py, parse_objdump.py, tcp_server.py]
2023-03-22 Heap corruption fix (due to write after 'on_release') + 'rule' renamed to 'watchpoint' + label highlighting
    [cms_program.cpp, continuous_monitoring_system_controller.py, ecg_program.cpp, gui_cms.cpp, gui_cms.h, gui_cms_states.h, gui_state_edit_watchpoint.cpp, gui_state_edit_watchpoint.h]
2023-03-27 Updated sensors_extension (digital inputs)
2023-03-31 Remove reset after TAMC_GT911 fix (manual) The fix is not a part of TAMC_GT911 library release yet. It must be applied manually (as of 31/03/2023), the fix is described in this issue: https://github.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
    ```
    Easy to sort in the TAMC_GT911.cpp. In the reset () add
    delay(50);
    checkCorrectAddr ();
    readBlockData(configBuf, GT911_CONFIG_START, GT911_CONFIG_SIZE);
    Then create a new routine
    void TAMC_GT911::checkCorrectAddr(void) {
    //Need to solve floating INT pin so on reset changes between the 2 addresses
    uint8_t returnSize;
    Wire.beginTransmission(addr);
    Wire.write(highByte(GT911_PRODUCT_ID));
    Wire.write(lowByte(GT911_PRODUCT_ID));
    Wire.endTransmission();
    returnSiz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
2023-05-25 Renamed ESP32-3248S035C_display_board directory
